kaszmirek/LOREM/3D/motor_holder.FCStd

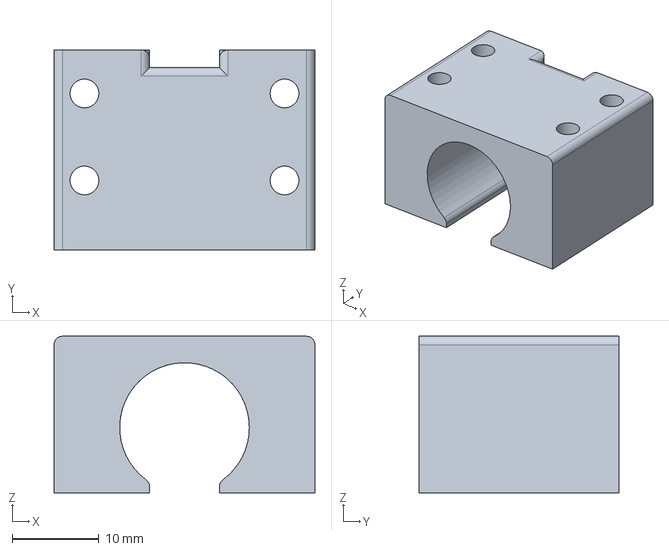
[picture p1: CAD file, 2026-04-25]
3D/motor_holder.FCStd
30.0 x 23.0 x 18.0 mm
