kaszmirek/LOREM/hardware/minisumo.pdf

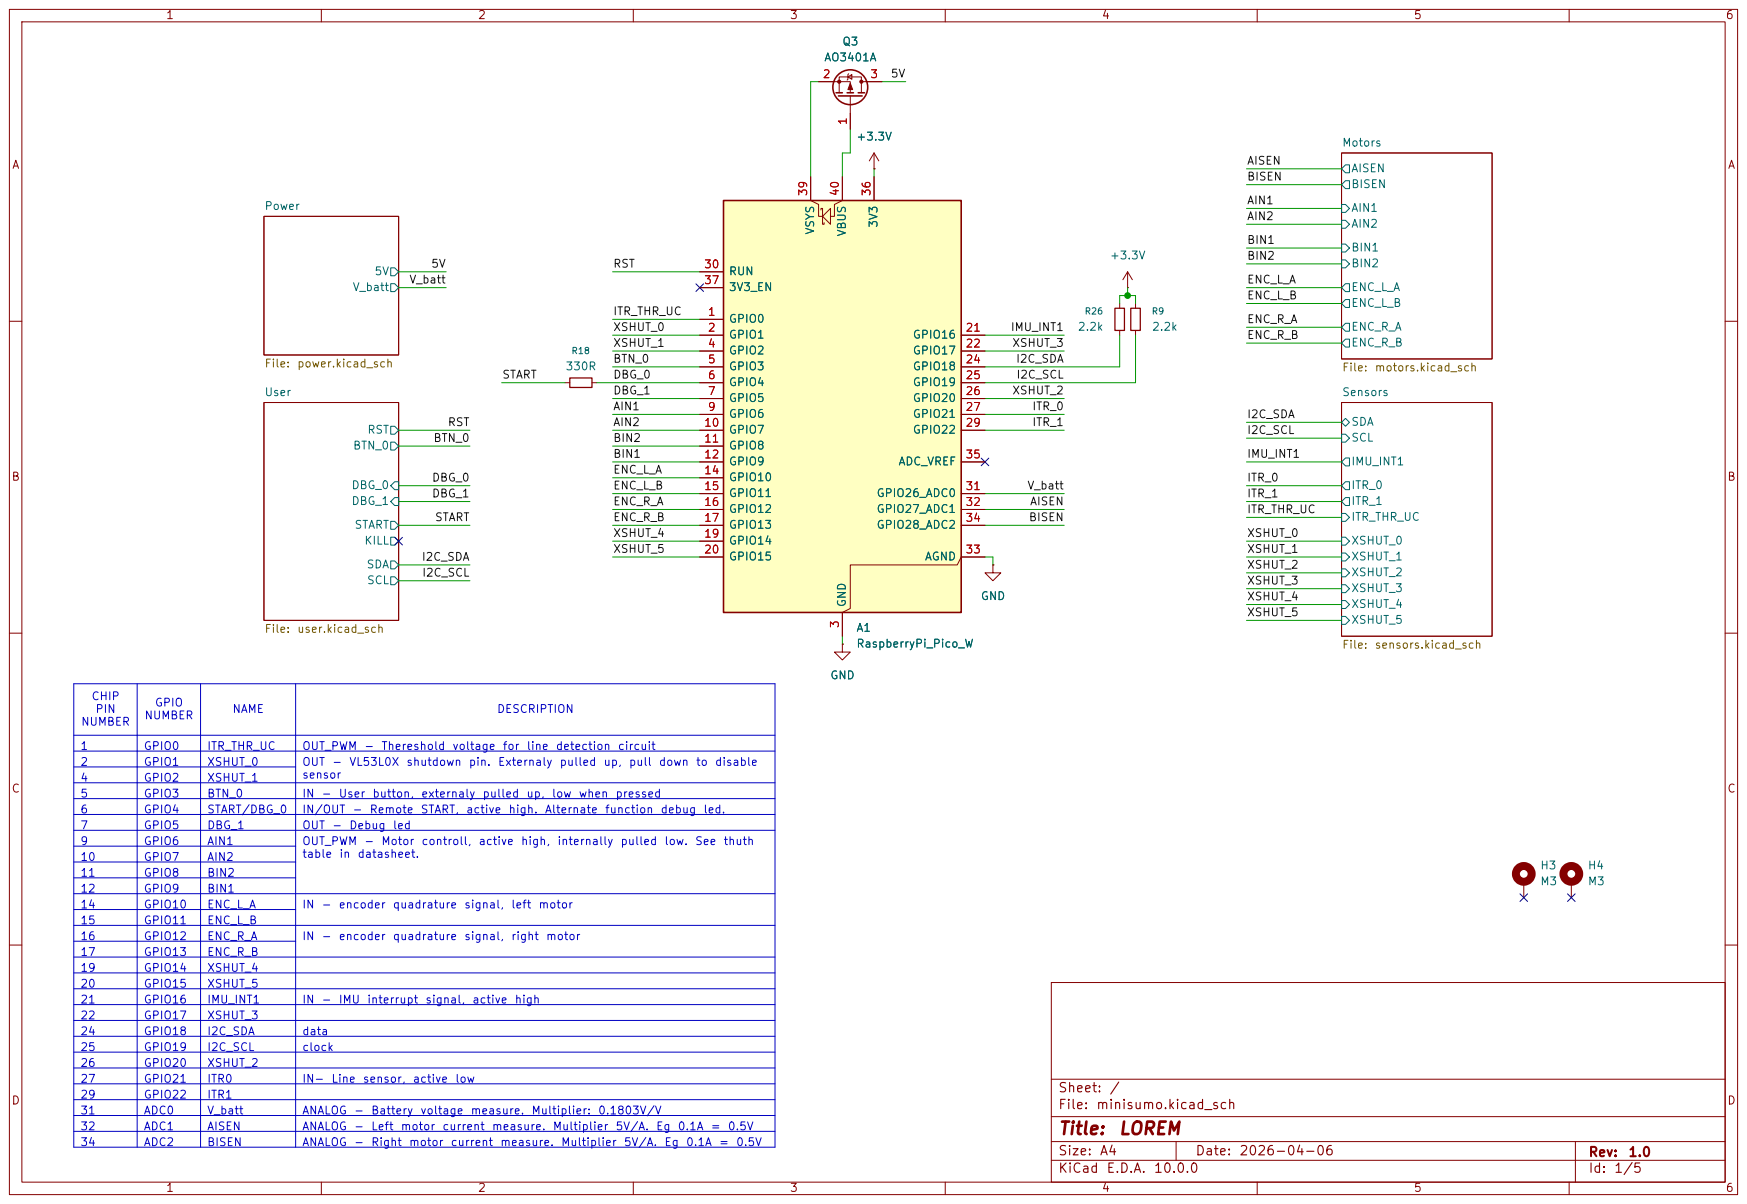
[picture p2: page 1]

BISEN Motors File: motors.kicad_sch DBG_1 DBG_0 BTN_0 KILL START SDA SCL RST User File: user.kicad_sch

14 | GPIO10 GPIO11 | ENC_L_A ENC_L_B | IN - encoder quadrature signal, left motor 15

16 | GPIO12 GPIO13 | ENC_R_A ENC_R_B | IN - encoder quadrature signal, right motor 17

19 | GPIO14 | XSHUT_4
20 | GPIO15 | XSHUT_5
21 | GPIO16 GPIO17 | IMU_INT1 XSHUT_3 | IN - IMU interrupt signal, active high 22

24 | GPIO18 GPIO19 GPIO20 | I2C_SDA I2C_SCL XSHUT_2 | data 25 clock 26

27 | GPIO21 | ITR0 | IN- Line sensor, active low

Size: A4 | Rev: 1.0

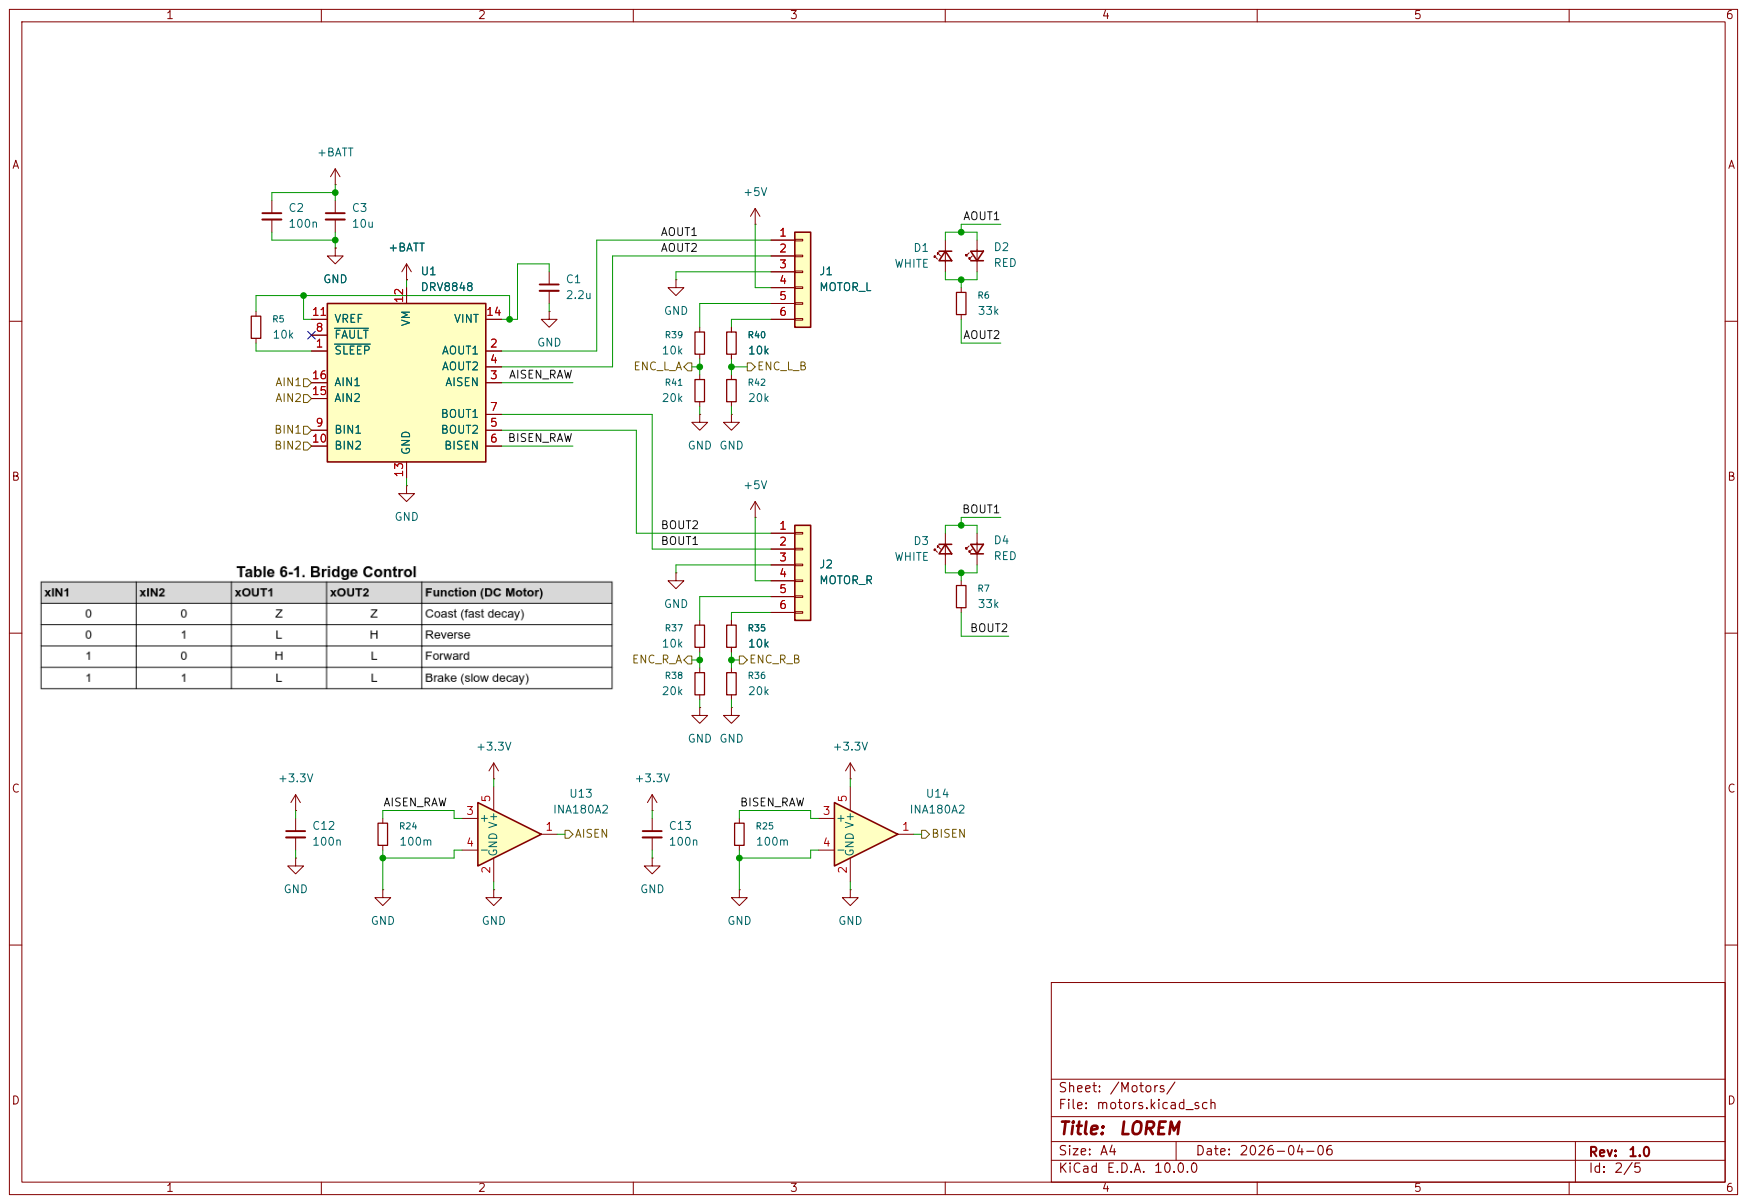
[picture p3: page 2]

2 2
3 3 4 4

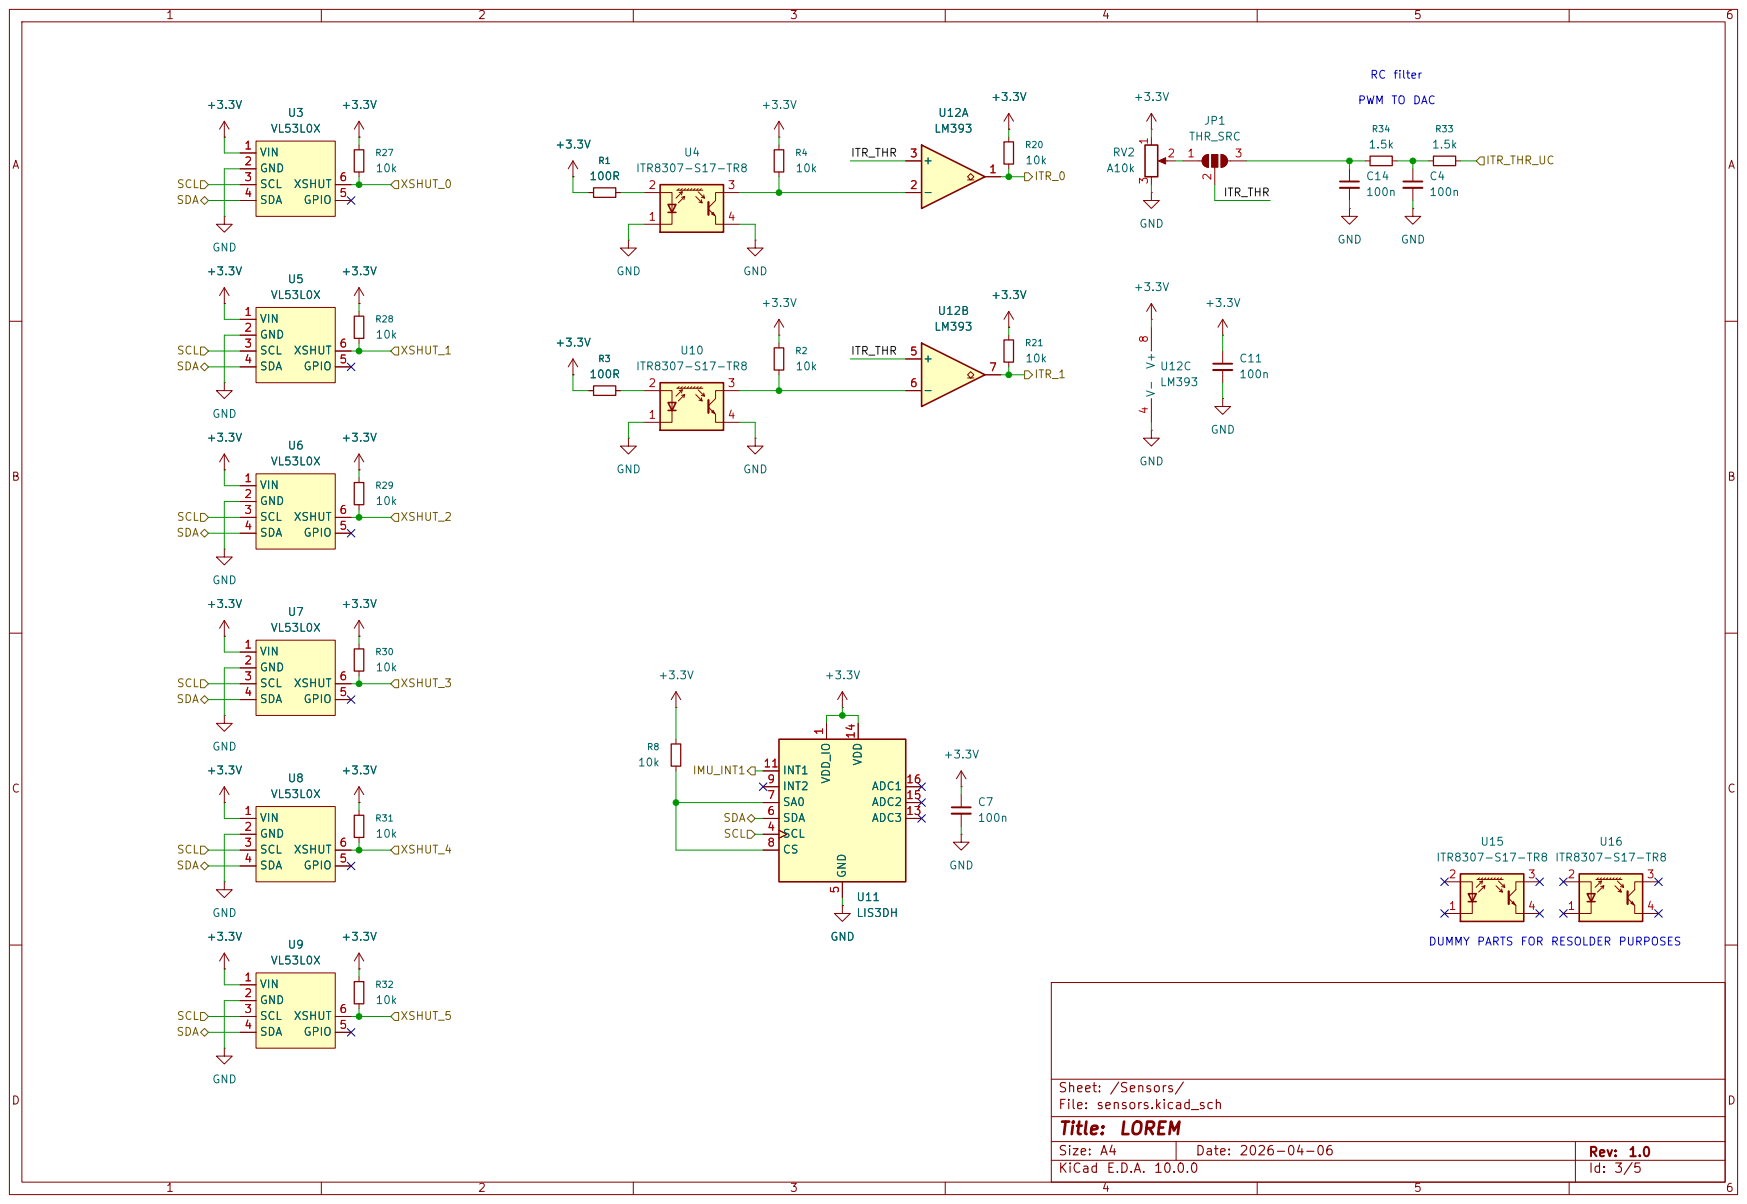
[picture p4: page 3]

RC filter PWM TO DAC

DUMMY PARTS FOR RESOLDER PURPOSES

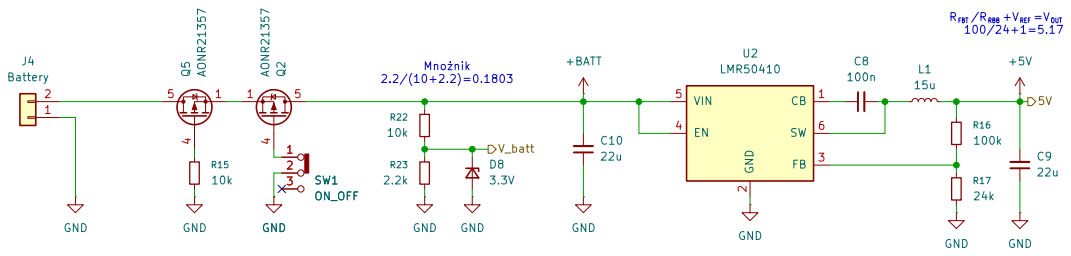
[picture p5: page 4]

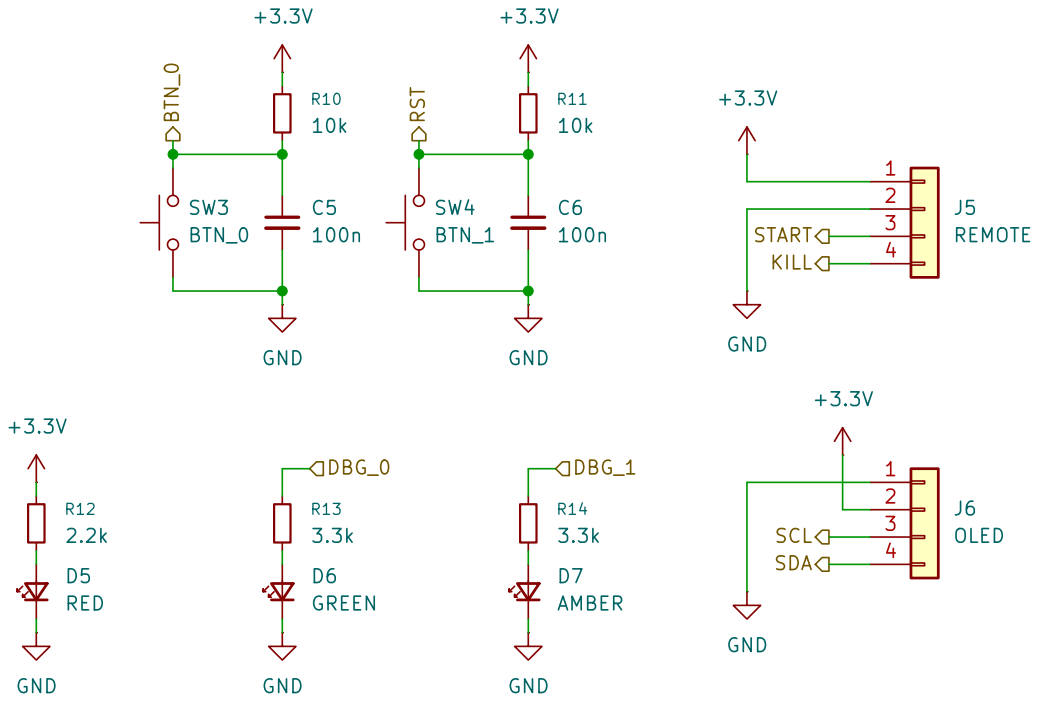
[picture p6: page 5]
