kaszmirek/LOREM/hardware/plots/minisumo__Assembly.pdf

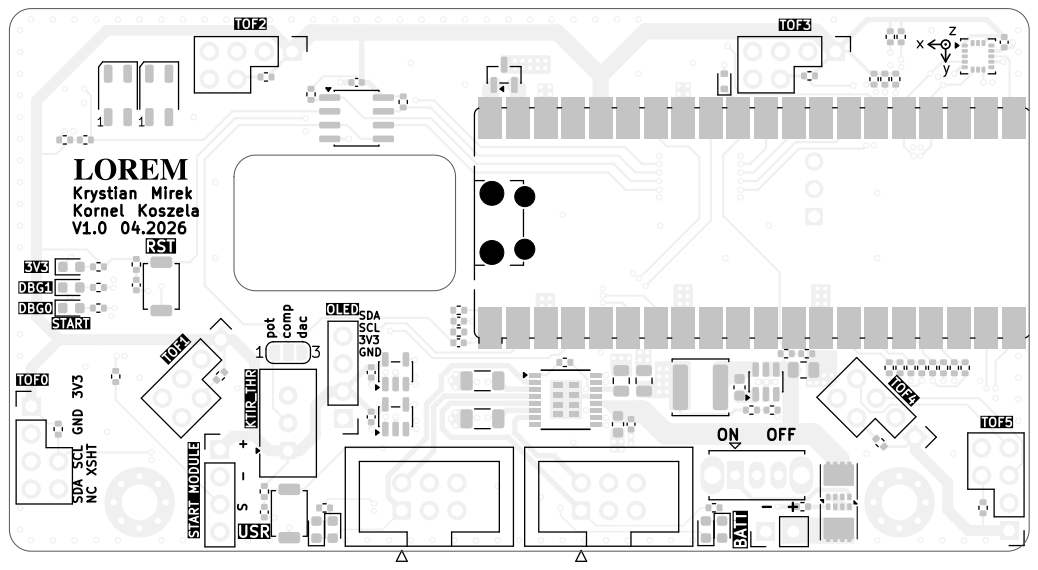
[picture p7: page 1]
SDA SCL 3V3 GND SDA SCL GND 3V3 NC XSHT; pot comp dac; z Krystian Mirek Kornel Koszela; OFF - + 1

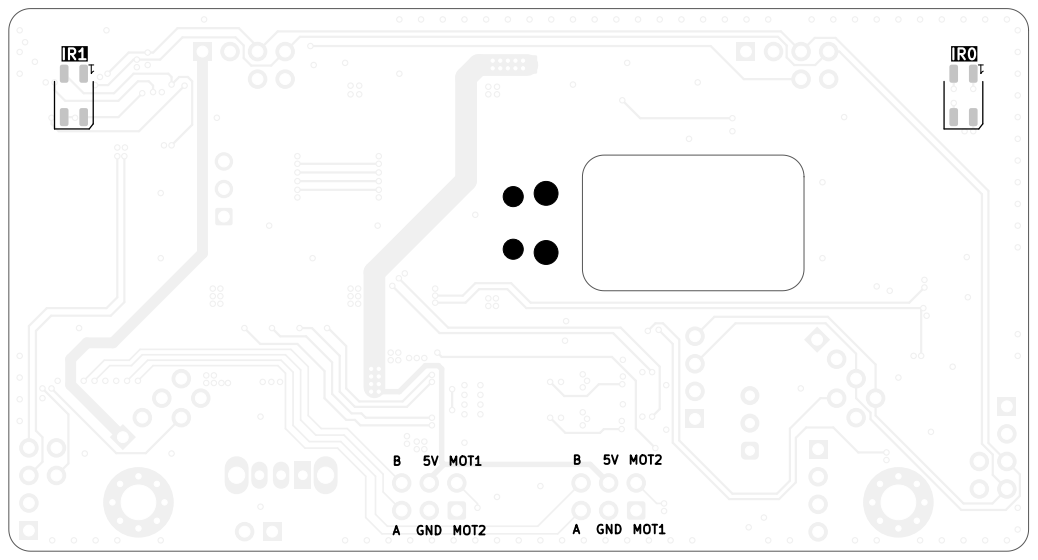
[picture p8: page 2]
5V MOT2; GND MOT1 B; MOT1; GND MOT2
