kaszmirek/LOREM/hardware/minisumo.kicad_pcb

## KiCad design hardware/minisumo.kicad_pcb (2026-04-06)

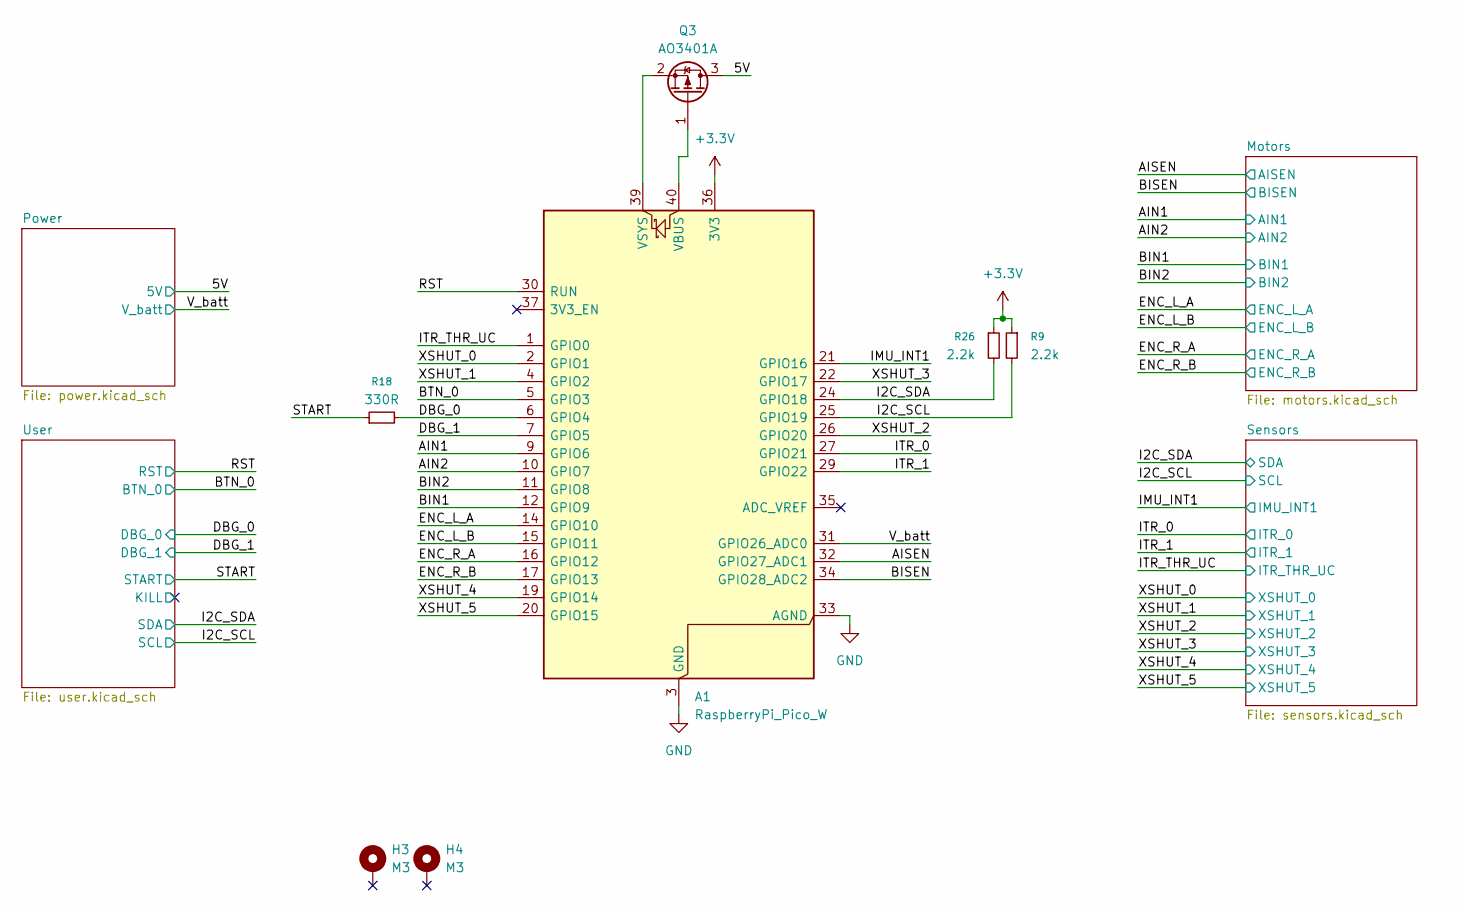
[picture p9: schematic minisumo.kicad_sch, LOREM]

Parts:
A1: RaspberryPi_Pico_W; RaspberryPi_Pico_W_SMD_HandSolder
H3, H4: M3; MountingHole_3.2mm_M3_Pad_Via
Q3: AO3401A; SOT-23
R9, R26: 2.2k; R_0402_1005Metric
R18: 330R; R_0402_1005Metric

Connections:
+3.3V: A1.36 (3V3), R9.1, R26.1; also elsewhere on the board
+5V: Q3.3 (D); also elsewhere on the board
/AIN1: A1.9 (GPIO6); also elsewhere on the board
/AIN2: A1.10 (GPIO7); also elsewhere on the board
/AISEN: A1.32 (GPIO27_ADC1); also elsewhere on the board
/BIN1: A1.12 (GPIO9); also elsewhere on the board
/BIN2: A1.11 (GPIO8); also elsewhere on the board
/BISEN: A1.34 (GPIO28_ADC2); also elsewhere on the board
/BTN_0: A1.5 (GPIO3); also elsewhere on the board
/DBG_0: A1.6 (GPIO4), R18.2; also elsewhere on the board
/DBG_1: A1.7 (GPIO5); also elsewhere on the board
/ENC_L_A: A1.14 (GPIO10); also elsewhere on the board
/ENC_L_B: A1.15 (GPIO11); also elsewhere on the board
/ENC_R_A: A1.16 (GPIO12); also elsewhere on the board
/ENC_R_B: A1.17 (GPIO13); also elsewhere on the board
/I2C_SCL: A1.25 (GPIO19), R9.2; also elsewhere on the board
/I2C_SDA: A1.24 (GPIO18), R26.2; also elsewhere on the board
/IMU_INT1: A1.21 (GPIO16); also elsewhere on the board
/ITR_0: A1.27 (GPIO21); also elsewhere on the board
/ITR_1: A1.29 (GPIO22); also elsewhere on the board
/ITR_THR_UC: A1.1 (GPIO0); also elsewhere on the board
/RST: A1.30 (RUN); also elsewhere on the board
/START: R18.1; also elsewhere on the board
/V_batt: A1.31 (GPIO26_ADC0); also elsewhere on the board
/XSHUT_0: A1.2 (GPIO1); also elsewhere on the board
/XSHUT_1: A1.4 (GPIO2); also elsewhere on the board
/XSHUT_2: A1.26 (GPIO20); also elsewhere on the board
/XSHUT_3: A1.22 (GPIO17); also elsewhere on the board
/XSHUT_4: A1.19 (GPIO14); also elsewhere on the board
/XSHUT_5: A1.20 (GPIO15); also elsewhere on the board
GND: A1.3 (GND), A1.8 (GND), A1.13 (GND), A1.18 (GND), A1.23 (GND), A1.28 (GND), A1.33 (AGND), A1.38 (GND); also elsewhere on the board
unnamed: A1.40 (VBUS), Q3.1 (G)
unnamed: A1.39 (VSYS), Q3.2 (S)

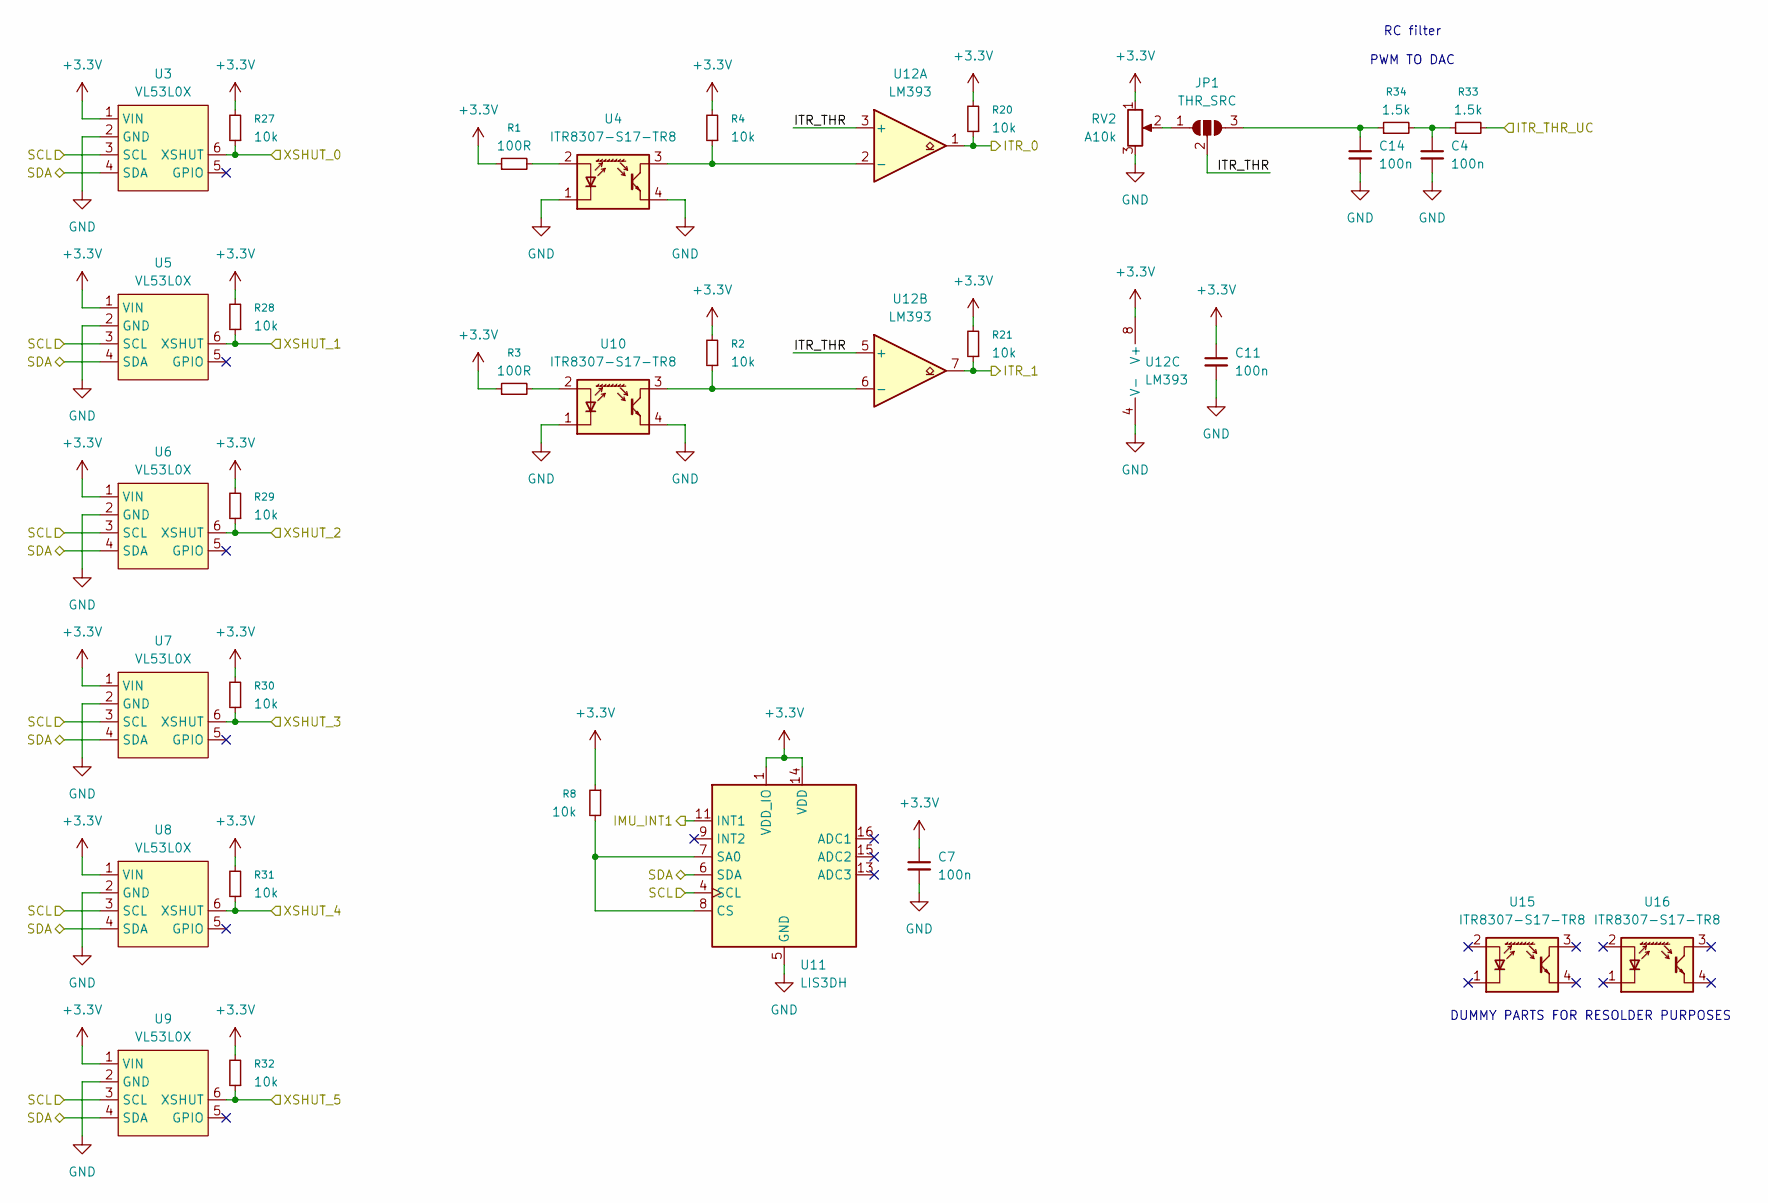
[picture p10: schematic sensors.kicad_sch, LOREM]

Parts:
C4, C7, C11, C14: 100n; C_0402_1005Metric
JP1: THR_SRC; SolderJumper-3_P1.3mm_Open_RoundedPad1.0x1.5mm_NumberLabels
R1, R3: 100R; R_0402_1005Metric
R2, R4, R8, R20, R21, R27, R28, R29, R30, R31, R32: 10k; R_0402_1005Metric
R33, R34: 1.5k; R_0402_1005Metric
RV2: A10k; Potentiometer_Vishay_T93YA_Vertical
U3, U5, U6, U7, U8, U9: VL53L0X
U4, U10, U15, U16: ITR8307-S17-TR8; Everlight_ITR1201SR10AR
U11: LIS3DH; LGA-16_3x3mm_P0.5mm_LayoutBorder3x5y
U12: LM393; SOIC-8_3.9x4.9mm_P1.27mm

Connections:
+3.3V: C7.1, C11.1, R1.1, R2.2, R3.1, R4.2, R8.1, R20.2, R21.2, R27.2, R28.2, R29.2, R30.2, R31.2, R32.2, RV2.1, U3.1 (VIN), U5.1 (VIN), U6.1 (VIN), U7.1 (VIN), U8.1 (VIN), U9.1 (VIN), U11.1 (VDD_IO), U11.14 (VDD), U12.8 (V+); also elsewhere on the board
/I2C_SCL: U3.3 (SCL), U5.3 (SCL), U6.3 (SCL), U7.3 (SCL), U8.3 (SCL), U9.3 (SCL), U11.4 (SCL); also elsewhere on the board
/I2C_SDA: U3.4 (SDA), U5.4 (SDA), U6.4 (SDA), U7.4 (SDA), U8.4 (SDA), U9.4 (SDA), U11.6 (SDA); also elsewhere on the board
/IMU_INT1: U11.11 (INT1); also elsewhere on the board
/ITR_0: R20.1, U12.1; also elsewhere on the board
/ITR_1: R21.1, U12.7; also elsewhere on the board
/ITR_THR_UC: R33.2; also elsewhere on the board
/Sensors/ITR_THR: JP1.2 (C), U12.3 (+), U12.5 (+)
/XSHUT_0: R27.1, U3.6 (XSHUT); also elsewhere on the board
/XSHUT_1: R28.1, U5.6 (XSHUT); also elsewhere on the board
/XSHUT_2: R29.1, U6.6 (XSHUT); also elsewhere on the board
/XSHUT_3: R30.1, U7.6 (XSHUT); also elsewhere on the board
/XSHUT_4: R31.1, U8.6 (XSHUT); also elsewhere on the board
/XSHUT_5: R32.1, U9.6 (XSHUT); also elsewhere on the board
GND: C4.2, C7.2, C11.2, C14.2, RV2.3, U3.2 (GND), U4.1 (K), U4.4, U5.2 (GND), U6.2 (GND), U7.2 (GND), U8.2 (GND), U9.2 (GND), U10.1 (K), U10.4, U11.5 (GND), U11.10 (GND), U11.12 (GND), U12.4 (V-); also elsewhere on the board
unnamed: C4.1, R33.1, R34.2
unnamed: JP1.1 (A), RV2.2
unnamed: C14.1, JP1.3 (B), R34.1
unnamed: R1.2, U4.2 (A)
unnamed: R3.2, U10.2 (A)
unnamed: R8.2, U11.7 (SA0), U11.8 (CS)
unnamed: R4.1, U4.3, U12.2 (-)
unnamed: R2.1, U10.3, U12.6 (-)

Notes on the sheet:
RC filter PWM TO DAC
DUMMY PARTS FOR RESOLDER PURPOSES

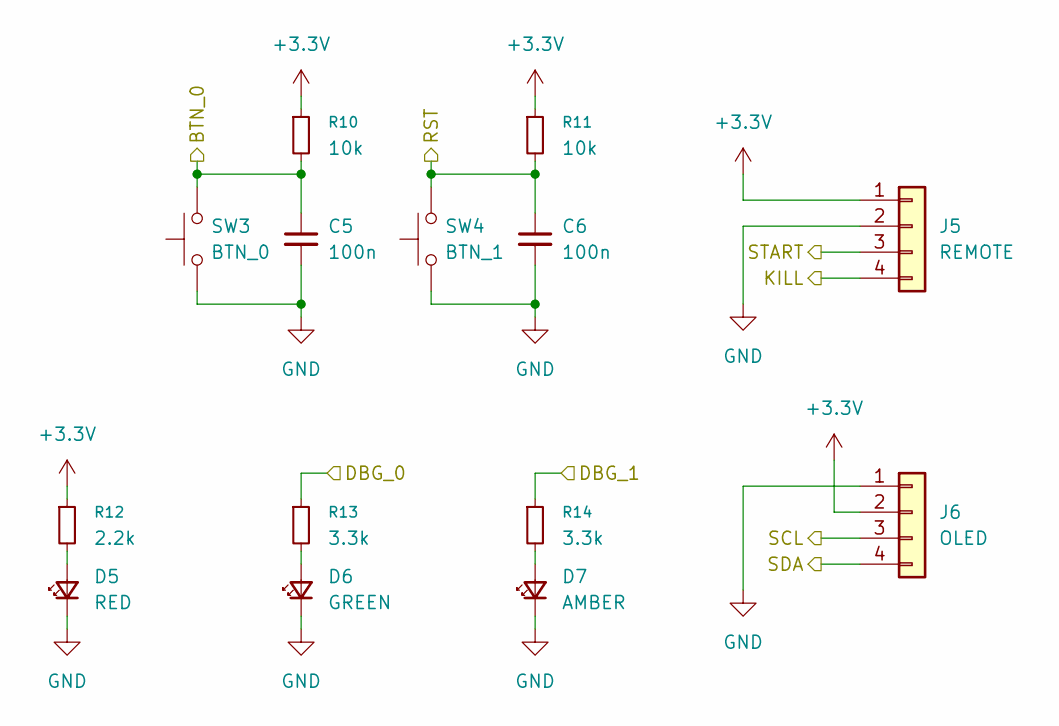
[picture p11: schematic user.kicad_sch, LOREM]

Parts:
C5, C6: 100n; C_0402_1005Metric
D5: RED; LED_0603_1608Metric
D6: GREEN; LED_0603_1608Metric
D7: AMBER; LED_0603_1608Metric
J5: REMOTE; PinHeader_1x04_P2.54mm_Vertical
J6: OLED; PinHeader_1x04_P2.54mm_Vertical
R10, R11: 10k; R_0402_1005Metric
R12: 2.2k; R_0402_1005Metric
R13, R14: 3.3k; R_0402_1005Metric
SW3: BTN_0; SW_SPST_TS-1088-xR020
SW4: BTN_1; SW_SPST_TS-1088-xR020

Connections:
+3.3V: J5.1, J6.2, R10.1, R11.1, R12.1; also elsewhere on the board
/BTN_0: C5.1, R10.2, SW3.2; also elsewhere on the board
/DBG_0: R13.1; also elsewhere on the board
/DBG_1: R14.1; also elsewhere on the board
/I2C_SCL: J6.3; also elsewhere on the board
/I2C_SDA: J6.4; also elsewhere on the board
/RST: C6.1, R11.2, SW4.2; also elsewhere on the board
/START: J5.3; also elsewhere on the board
/User/KILL: J5.4
GND: C5.2, C6.2, D5.1 (K), D6.1 (K), D7.1 (K), J5.2, J6.1, SW3.1, SW4.1; also elsewhere on the board
unnamed: D5.2 (A), R12.2
unnamed: D6.2 (A), R13.2
unnamed: D7.2 (A), R14.2

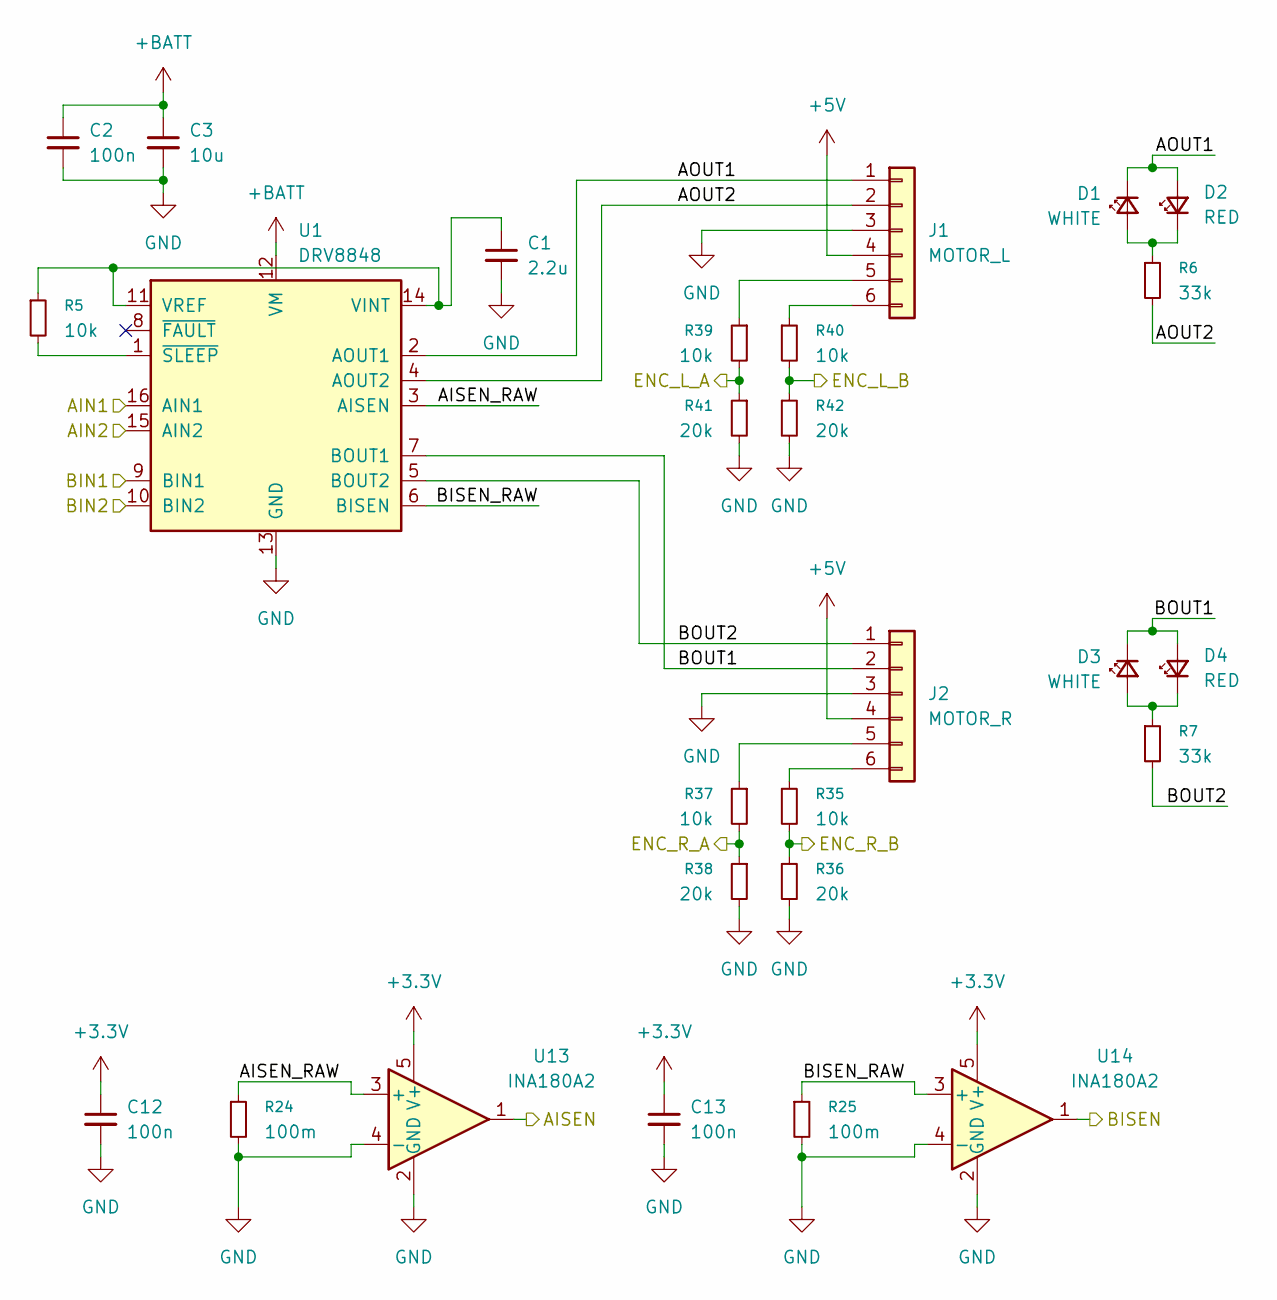
[picture p12: schematic motors.kicad_sch, LOREM]

Parts:
C1: 2.2u; C_0805_2012Metric
C2, C12, C13: 100n; C_0402_1005Metric
C3: 10u; C_0603_1608Metric
D1, D3: WHITE; LED_0603_1608Metric
D2, D4: RED; LED_0603_1608Metric
J1: MOTOR_L; IDC-Header_2x03_P2.54mm_Vertical
J2: MOTOR_R; IDC-Header_2x03_P2.54mm_Vertical
R5, R35, R37, R39, R40: 10k; R_0402_1005Metric
R6, R7: 33k; R_0402_1005Metric
R24, R25: 100m; R_1206_3216Metric
R36, R38, R41, R42: 20k; R_0402_1005Metric
U1: DRV8848; TSSOP-16-1EP_4.4x5mm_P0.65mm
U13, U14: INA180A2; SOT-23-5

Connections:
+3.3V: C12.1, C13.1, U13.5 (V+), U14.5 (V+); also elsewhere on the board
+5V: J1.4, J2.4; also elsewhere on the board
+BATT: C2.1, C3.1, U1.12 (VM); also elsewhere on the board
/AIN1: U1.16 (AIN1); also elsewhere on the board
/AIN2: U1.15 (AIN2); also elsewhere on the board
/AISEN: U13.1; also elsewhere on the board
/BIN1: U1.9 (BIN1); also elsewhere on the board
/BIN2: U1.10 (BIN2); also elsewhere on the board
/BISEN: U14.1; also elsewhere on the board
/ENC_L_A: R39.2, R41.1; also elsewhere on the board
/ENC_L_B: R40.2, R42.1; also elsewhere on the board
/ENC_R_A: R37.2, R38.1; also elsewhere on the board
/ENC_R_B: R35.2, R36.1; also elsewhere on the board
/Motors/AISEN_RAW: R24.1, U1.3 (AISEN), U13.3 (+)
/Motors/AOUT1: D1.1 (K), D2.2 (A), J1.1, U1.2 (AOUT1)
/Motors/AOUT2: J1.2, R6.2, U1.4 (AOUT2)
/Motors/BISEN_RAW: R25.1, U1.6 (BISEN), U14.3 (+)
/Motors/BOUT1: D3.1 (K), D4.2 (A), J2.2, U1.7 (BOUT1)
/Motors/BOUT2: J2.1, R7.2, U1.5 (BOUT2)
GND: C1.2, C2.2, C3.2, C12.2, C13.2, J1.3, J2.3, R24.2, R25.2, R36.2, R38.2, R41.2, R42.2, U1.13 (GND), U1.17 (GND), U13.2 (GND), U13.4 (-), U14.2 (GND), U14.4 (-); also elsewhere on the board
unnamed: D1.2 (A), D2.1 (K), R6.1
unnamed: D3.2 (A), D4.1 (K), R7.1
unnamed: J1.5, R39.1
unnamed: J1.6, R40.1
unnamed: J2.5, R37.1
unnamed: J2.6, R35.1
unnamed: C1.1, R5.1, U1.11 (VREF), U1.14 (VINT)
unnamed: R5.2, U1.1 (~SLEEP)

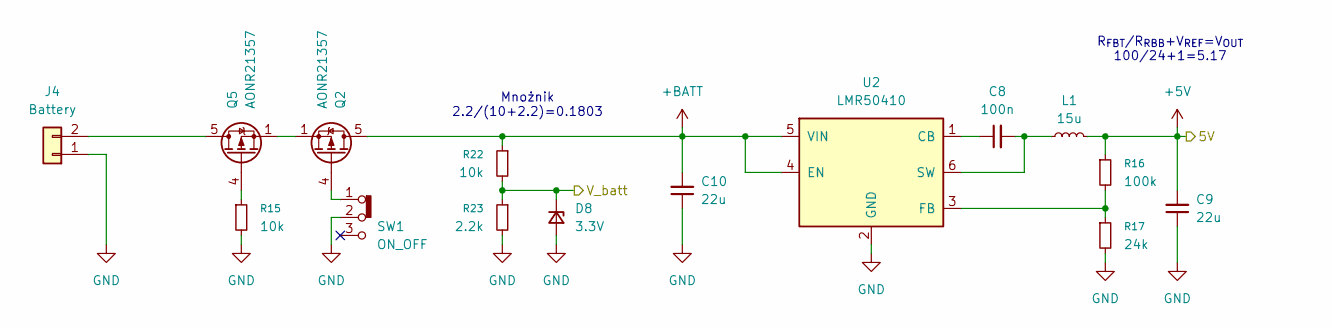
[picture p13: schematic power.kicad_sch, LOREM]

Parts:
C8: 100n; C_0603_1608Metric
C9, C10: 22u; C_0805_2012Metric
D8: 3.3V; D_SOD-523
J4: Battery; PinHeader_1x02_P2.54mm_Vertical
L1: 15u; L_APV_ANR5040
Q2, Q5: AONR21357; DFN_3.3x3.3
R15, R22: 10k; R_0402_1005Metric
R16: 100k; R_0402_1005Metric
R17: 24k; R_0402_1005Metric
R23: 2.2k; R_0402_1005Metric
SW1: ON_OFF; SW_Slide_SPDT_Straight_CK_OS102011MS2Q
U2: LMR50410; SOT-23-6

Connections:
+5V: C9.2, L1.2, R16.1; also elsewhere on the board
+BATT: C10.2, Q2.5 (D), R22.1, U2.4 (EN), U2.5 (VIN); also elsewhere on the board
/V_batt: D8.1 (K), R22.2, R23.1; also elsewhere on the board
GND: C9.1, C10.1, D8.2 (A), J4.1, R15.2, R17.2, R23.2, SW1.2 (B), U2.2 (GND); also elsewhere on the board
unnamed: J4.2, Q5.5 (D)
unnamed: Q2.4 (G), SW1.1 (A)
unnamed: Q2.1 (S), Q2.2 (S), Q2.3 (S), Q5.1 (S), Q5.2 (S), Q5.3 (S)
unnamed: Q5.4 (G), R15.1
unnamed: C8.1, U2.1 (CB)
unnamed: R16.2, R17.1, U2.3 (FB)
unnamed: C8.2, L1.1, U2.6 (SW)

Notes on the sheet:
R_{FBT}/R_{RBB}+V_{REF}=V_{OUT} 100/24+1=5.17
Mnożnik 2.2/(10+2.2)=0.1803

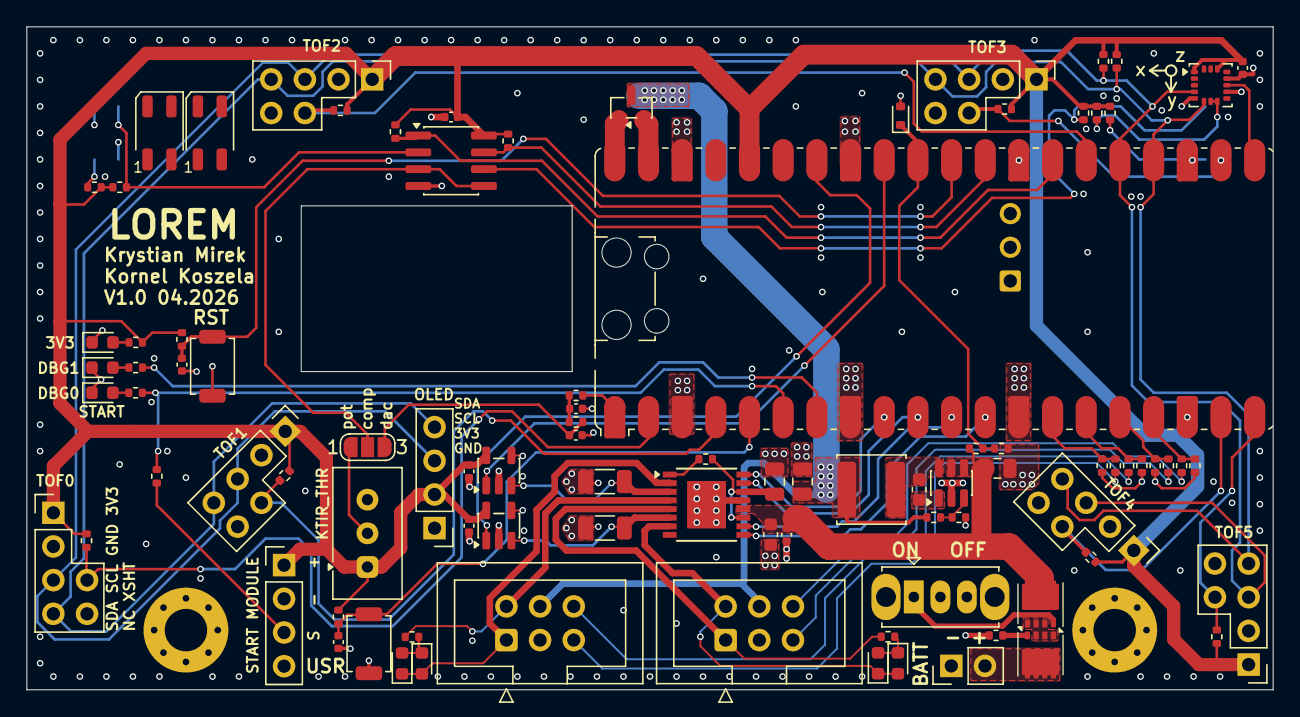
[picture p14: board minisumo.kicad_pcb from above]

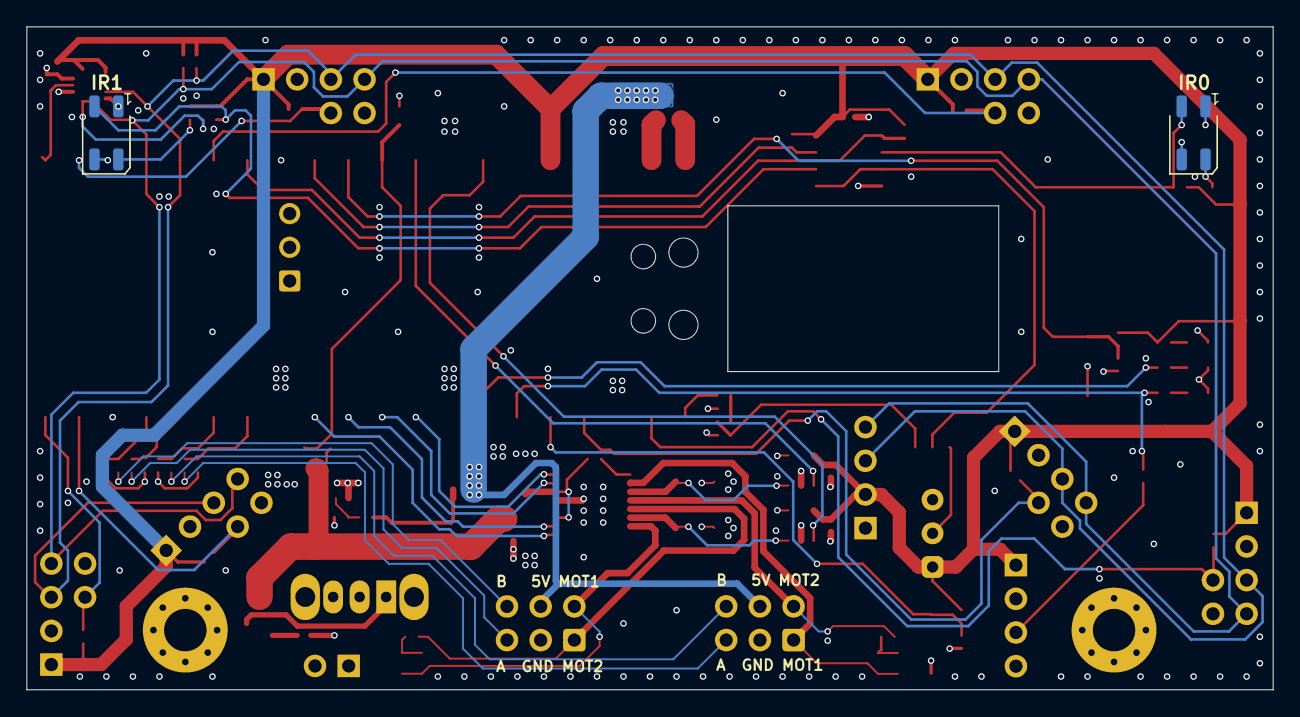
[picture p15: board minisumo.kicad_pcb from below]

Board: 4 copper layers, 94.0 x 50.0 mm, 96 parts (2 on the bottom side), 67 nets.
