kaszmirek/LOREM/firmware/src/oled.cpp

#include "oled.h"
#include <cstdio>

// 5×7 font, column-major, LSB = top row. ASCII 0x20–0x7E.
static constexpr uint8_t font[95][5] = {
    {0x00,0x00,0x00,0x00,0x00}, // 0x20 ' '
    {0x00,0x00,0x5F,0x00,0x00}, // 0x21 '!'
    {0x00,0x07,0x00,0x07,0x00}, // 0x22 '"'
    {0x14,0x7F,0x14,0x7F,0x14}, // 0x23 '#'
    {0x24,0x2A,0x7F,0x2A,0x12}, // 0x24 '$'
    {0x23,0x13,0x08,0x64,0x62}, // 0x25 '%'
    {0x36,0x49,0x55,0x22,0x50}, // 0x26 '&'
    {0x00,0x05,0x03,0x00,0x00}, // 0x27 '\''
    {0x00,0x1C,0x22,0x41,0x00}, // 0x28 '('
    {0x00,0x41,0x22,0x1C,0x00}, // 0x29 ')'
    {0x14,0x08,0x3E,0x08,0x14}, // 0x2A '*'
    {0x08,0x08,0x3E,0x08,0x08}, // 0x2B '+'
    {0x00,0x50,0x30,0x00,0x00}, // 0x2C ','
    {0x08,0x08,0x08,0x08,0x08}, // 0x2D '-'
    {0x00,0x60,0x60,0x00,0x00}, // 0x2E '.'
    {0x20,0x10,0x08,0x04,0x02}, // 0x2F '/'
    {0x3E,0x51,0x49,0x45,0x3E}, // 0x30 '0'
    {0x00,0x42,0x7F,0x40,0x00}, // 0x31 '1'
    {0x42,0x61,0x51,0x49,0x46}, // 0x32 '2'
    {0x21,0x41,0x45,0x4B,0x31}, // 0x33 '3'
    {0x18,0x14,0x12,0x7F,0x10}, // 0x34 '4'
    {0x27,0x45,0x45,0x45,0x39}, // 0x35 '5'
    {0x3C,0x4A,0x49,0x49,0x30}, // 0x36 '6'
    {0x01,0x71,0x09,0x05,0x03}, // 0x37 '7'
    {0x36,0x49,0x49,0x49,0x36}, // 0x38 '8'
    {0x06,0x49,0x49,0x29,0x1E}, // 0x39 '9'
    {0x00,0x36,0x36,0x00,0x00}, // 0x3A ':'
    {0x00,0x56,0x36,0x00,0x00}, // 0x3B ';'
    {0x08,0x14,0x22,0x41,0x00}, // 0x3C '<'
    {0x14,0x14,0x14,0x14,0x14}, // 0x3D '='
    {0x00,0x41,0x22,0x14,0x08}, // 0x3E '>'
    {0x02,0x01,0x51,0x09,0x06}, // 0x3F '?'
    {0x32,0x49,0x79,0x41,0x3E}, // 0x40 '@'
    {0x7E,0x11,0x11,0x11,0x7E}, // 0x41 'A'
    {0x7F,0x49,0x49,0x49,0x36}, // 0x42 'B'
    {0x3E,0x41,0x41,0x41,0x22}, // 0x43 'C'
    {0x7F,0x41,0x41,0x22,0x1C}, // 0x44 'D'
    {0x7F,0x49,0x49,0x49,0x41}, // 0x45 'E'
    {0x7F,0x09,0x09,0x09,0x01}, // 0x46 'F'
    {0x3E,0x41,0x49,0x49,0x7A}, // 0x47 'G'
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
};

void OLED::init() {
    static const uint8_t seq[] = {
        0xAE,             // display off
        0xD5, 0x80,       // clock div / osc freq
        0xA8, 0x1F,       // multiplex ratio = 31 (32 rows)
        0xD3, 0x00,       // display offset = 0
        0x40,             // start line = 0
        0x8D, 0x14,       // charge pump on
        0x20, 0x00,       // horizontal addressing mode
        0xA1,             // segment remap (col 127 → SEG0)
        0xC8,             // COM scan dec (row 31 → COM0)
        0xDA, 0x02,       // COM pins: sequential, no remap (128×32)
        0x81, 0x8F,       // contrast
        0xD9, 0xF1,       // pre-charge: p1=1, p2=15
        0xDB, 0x20,       // VCOM deselect
        0xA4,             // follow RAM
        0xA6,             // normal display (not inverted)
        0xAF,             // display on
    };
    for (uint8_t c : seq) _cmd(c);
    clear();
    display();
}

void OLED::clear() {
    memset(_buf, 0, sizeof(_buf));
}

void OLED::set_pixel(int x, int y, bool on) {
    if ((unsigned)x >= W || (unsigned)y >= H) return;
    uint8_t& b = _buf[(y / 8) * W + x];
    uint8_t  m = 1u << (y & 7);
    if (on) b |= m; else b &= ~m;
}

void OLED::print(int col, int row, const char* str) {
    for (int x = col * 6, y = row * 8; *str; str++, x += 6) {
        uint8_t c = (uint8_t)*str;
        if (c < 0x20 || c > 0x7E) continue;
        const uint8_t* g = font[c - 0x20];
        for (int cx = 0; cx < 5; cx++)
            for (int cy = 0; cy < 8; cy++)
                set_pixel(x + cx, y + cy, (g[cx] >> cy) & 1);
    }
}

void OLED::printf(int col, int row, const char* fmt, ...) {
    char buf[22];
    va_list ap; va_start(ap, fmt);
    vsnprintf(buf, sizeof(buf), fmt, ap);
    va_end(ap);
    print(col, row, buf);
}

void OLED::display() {
    _cmd(0x21); _cmd(0);   _cmd(W - 1);     // column 0–127
    _cmd(0x22); _cmd(0);   _cmd(PAGES - 1); // page 0–3
    uint8_t pkt[W * PAGES + 1];
    pkt[0] = 0x40;
    memcpy(pkt + 1, _buf, sizeof(_buf));
    i2c_write_blocking(_i2c, _addr, pkt, sizeof(pkt), false);
}

void OLED::_cmd(uint8_t c) {
    uint8_t pkt[2] = {0x00, c};
    i2c_write_blocking(_i2c, _addr, pkt, 2, false);
}
