kaszmirek/LOREM/(commit log)

2026-04-04 pcb and production files done
    [BOM-minisumo.csv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]
2026-04-15 description table update
    [minisumo.kicad_sch, motors.kicad_sch]
2026-04-16 motor holder
    [motor_holder.FCStd]
2026-04-24 feat: PID
2026-04-24 fix: encoder on timre instead
    [encoder.h]
2026-04-25 feat: imu
2026-04-25 fix: include imu shit in debug
    [engine_ramp.cpp]
2026-04-25 fix: filtering
2026-04-25 fix:better filtering
2026-04-25 lmao czujniki
    [motor_holder.FCStd]
